wagiminator/ATtiny13-TinyRemoteRF/hardware/TinyRemoteRF_BOM.tsv

ID | Name | Designator | Footprint | Quantity | Manufacturer Part | Manufacturer | Supplier | Supplier Part | LCSC Assembly
1 | 13.56MHz | X1 | OSC-SMD_3225 | 1 | CF4013M56010T8188040 | JWT | LCSC | C709015 | Yes
2 | 82nH | L2 | L0603 | 1 | SDCL1608C82NJTDF | Sunlord | LCSC | C23473
3 | CR2032-BS-6-1 | B1 | BATTERY-3 | 1 | CR2032-BS-6-1 | Q&J | LCSC | C70377
4 | ANT | H1 | HDR-M-2.54_1X1 | 1 |  |  | LCSC | C81276
5 | Tactile Switch 6*6*6mm | KEY2,KEY1,KEY3,KEY4,KEY5 | KEY-6.0*6.0 | 5 | SMD Tactile Switch6*6*6mm | ReliaPro | LCSC | C23873
6 | ATtiny13A | U1 | SOP-8_150MIL | 1 | ATTINY13A-SSU | MICROCHIP | LCSC | C14075
7 | 100k | R1 | 0603 | 1 | 0603WAF1003T5E | UniOhm | LCSC | C25803
8 | ICSP | H2 | ICSP-PADS-SMALL | 1 | MTP125-1203S1 | MINTRON | LCSC | C358692
9 | 12p | C4,C3 | 0603 | 2 | CL10C120JB8NNNC | SAMSUNG | LCSC | C38523
10 | 3p6 | C6 | 0603 | 1 | CL10C3R6BB8NNNC | Samsung Electro-Mechanics | LCSC | C159788
11 | 2p | C5 | 0603 | 1 | CL10C020CB8NNNC | SAMSUNG | LCSC | C21895
12 | 100p | C7 | 0603 | 1 | CL10C101JB8NNNC | SAMSUNG | LCSC | C14858
13 | 100n | C1,C8 | 0603 | 2 | CC0603KRX7R9BB104 | YAGEO | LCSC | C14663
14 | 10u | C2 | 0603 | 1 | C0603X5R106M160NT | SANYEAR | LCSC | C466781
15 | 150nH | L1 | L0603 | 1 | MLF1608DR15JT000 | TDK | LCSC | C87518
16 | SYN115 | U2 | SOT-23-6 | 1 |  | SYNOXO
