wagiminator/ATtiny13-TinyRemoteRF/hardware/TinyRemoteRF_schematic.pdf

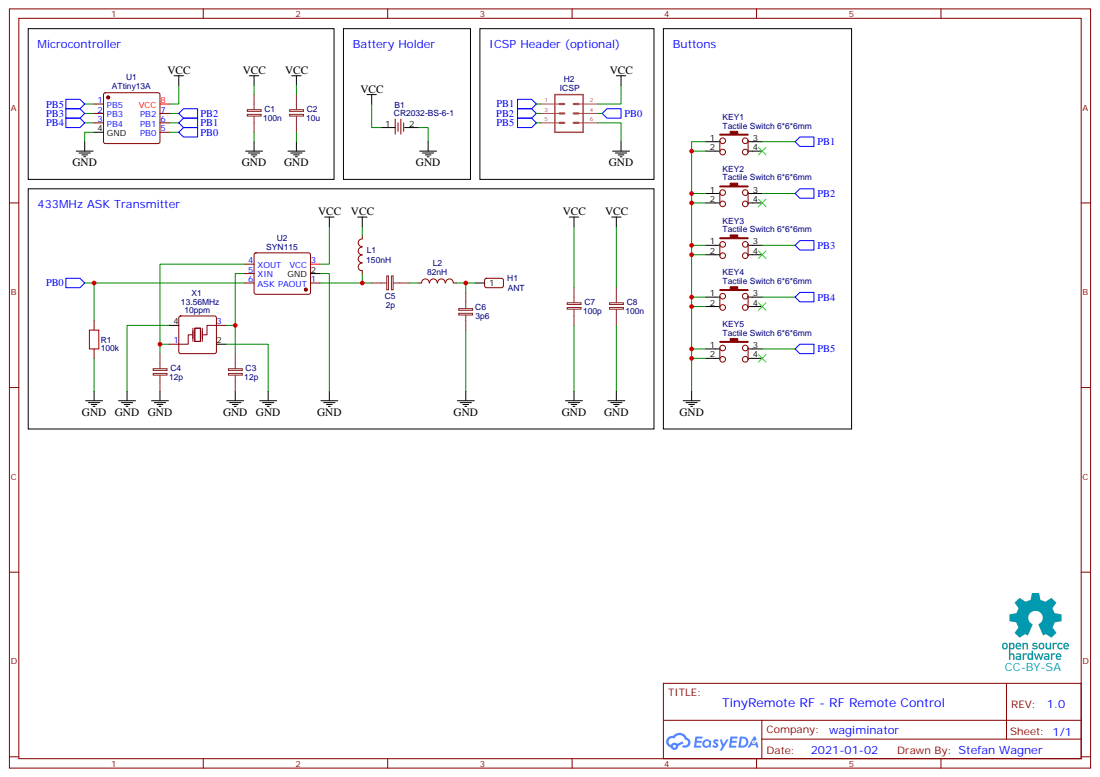
[picture p6: page 1]

Drawn By: Stefan Wagner
