wagiminator/ATtiny13-TinyRemoteRF/(threads)

Thread 1 (2022-02-14):

question about 315MHZ compatibility

JosephShepin, 2022-02-14:
I made a very similar (almost identical) board using the SYN115 following the data sheet as you appear to have done, however I made the 315mhz version of the board. After testing my transmitter and receiver using the radiohead library and a pair of arduino unos, I can confirm that they work, however using the code that you wrote for the ATTiny13 doesn't yield any positive results. Would you be aware of any reason that this code would need some modification for the 315mhz version of the circuit? Thanks

wagiminator, 2022-02-17:
This should actually work regardless of the transmission frequency. Please check whether the code for the transmitter and receiver has been compiled and uploaded correctly and whether the fuses are set correctly on the ATtiny13. In addition, the timing settings mentioned should be identical in the source codes.

wagiminator, 2022-02-19:
It is only important that if the code is compiled for a clock speed of 1.2MHz, then the ATtiny13's fuses are also set to run at 1.2MHz. Otherwise the timing is wrong. But I don't think that the ATtiny's internal oscillator needs to be additionally calibrated.

Closed 2022-02-24.
